jaguilar/self-balancing-cube/self-balancing-cube.ioc

Mcu.UserName=STM32G474MCTx
Mcu.UserName=STM32G474MCTx
PA10.GPIO_Label=M1_PHASEC
PA10.Signal=S_TIM1_CH3
PA11.Signal=USB_DM
PA12.Signal=USB_DP
PA13.GPIO_Label=SWDIO
PA13.Signal=SYS_JTMS-SWDIO
PA14.GPIO_Label=SWCLK
PA14.Signal=SYS_JTCK-SWCLK
PA15.GPIO_Label=I2C1_SCL
PA15.Signal=I2C1_SCL
PA2.GPIO_Label=BRAKE
PA2.Signal=COMP2_OUT
PA3.GPIO_Label=VBATT_SENSE_CMP
PA3.Signal=COMP2_INP
PA4.GPIO_Label=ENC2_CSN
PA4.Signal=S_TIM3_CH2
PA5.GPIO_Label=SPI1_SCLK
PA5.Signal=SPI1_SCK
PA6.GPIO_Label=SPI1_MISO
PA6.Signal=SPI1_MISO
PA7.GPIO_Label=M1_SENSEB
PA7.Signal=ADC2_IN4
PA8.GPIO_Label=M1_PHASEA
PA8.Signal=S_TIM1_CH1
PA9.Signal=USART1_TX
PB0.GPIO_Label=M1_SENSEA
PB0.Signal=ADC1_IN15
PB1.GPIO_Label=M1_NFAULT
PB1.Signal=GPXTI1
PB10.GPIO_Label=M1_NCS
PB10.Signal=GPIO_Output
PB11.GPIO_Label=M2_NCS
PB11.Signal=GPIO_Output
PB12.GPIO_Label=M3_SENSEA
PB12.Signal=ADC1_IN11
PB13.GPIO_Label=M3_NCS
PB13.Signal=GPIO_Output
PB14.GPIO_Label=M2_SENSEA
PB14.Signal=ADC1_IN5
PB15.GPIO_Label=M3_SENSEB
PB15.Signal=ADC2_IN15
PB2.GPIO_Label=M3_PHASEA
PB2.Signal=S_TIM20_CH1
PB3.GPIO_Label=SWO
PB3.Signal=SYS_JTDO-SWO
PB4.GPIO_Label=ENC1_CSN
PB4.Signal=S_TIM3_CH1
PB5.GPIO_Label=SPI1_MOSI
PB5.Signal=SPI1_MOSI
PB6.GPIO_Label=LED_DATA
PB6.Signal=S_TIM4_CH1
PB7.GPIO_Label=I2C1_SDA
PB7.Signal=I2C1_SDA
PB9.GPIO_Label=M2_PHASEC
PB9.Signal=S_TIM8_CH3
PC13.GPIO_Label=EN
PC13.Signal=GPIO_Output
PC14-OSC32_IN.GPIO_Label=CAL
PC14-OSC32_IN.Signal=GPIO_Output
PC2.GPIO_Label=M3_PHASEB
PC2.Signal=S_TIM20_CH2
PC4.GPIO_Label=M2_SENSEB
PC4.Signal=ADC2_IN5
PC5.Signal=USART1_RX
PC6.GPIO_Label=M2_PHASEA
PC6.Signal=S_TIM8_CH1
PC7.GPIO_Label=M2_PHASEB
PC7.Signal=S_TIM8_CH2
PC8.GPIO_Label=M3_PHASEC
PC8.Signal=S_TIM20_CH3
PC9.GPIO_Label=ENC3_CSN
PC9.Signal=S_TIM3_CH4
PD0.GPIO_Label=M1_nFAULT
PD0.Signal=GPIO_Input
PD10.GPIO_Label=M1_NCOAST
PD10.Signal=ADC3_IN7
PD10.Signal=GPIO_Output
PD2.GPIO_Label=IMU_INT
PD2.Signal=GPXTI2
PD8.GPIO_Label=M3_NCOAST
PD8.Signal=GPIO_Output
PD9.GPIO_Label=M2_NCOAST
PD9.Signal=GPIO_Output
PE11.GPIO_Label=M1_PHASEB
PE11.Signal=S_TIM1_CH2
PE12.GPIO_Label=M3_NFAULT
PE12.Signal=GPXTI12
PE13.GPIO_Label=M2_SENSEC
PE13.Signal=ADC3_IN3
PE14.GPIO_Label=VBATT_SENSE
PE14.Signal=ADC4_IN1
PE15.GPIO_Label=IMU_INT
PE15.Signal=GPXTI15
PE7.GPIO_Label=M3_SENSEC
PE7.Signal=ADC3_IN4
PE8.GPIO_Label=M2_NFAULT
PE8.Signal=GPXTI8
PE9.GPIO_Label=M1_SENSEC
PE9.Signal=ADC3_IN2
PF0-OSC_IN.Signal=RCC_OSC_IN
