jaguilar/self-balancing-cube/src/as5048a_spi_sensor.cc

#include "as5048a_spi_sensor.h"

#include <cassert>

#include "cmsis_os2.h"
#include "stm32g4xx_ll_dmamux.h"
#include "stm32g4xx_ll_gpio.h"
#include "stm32g4xx_ll_spi.h"
#include "stm32g4xx_ll_tim.h"
#include "stm32g4xx_ll_usart.h"

namespace stfoc {

namespace internal {
void BusyWaitNs(uint32_t ns) {
  uint32_t start = DWT->CYCCNT;
  uint32_t wait_ticks =
      static_cast<uint32_t>(1.0f * ns * SystemCoreClock / 1e9f);
  while ((uint32_t)(DWT->CYCCNT - start) < wait_ticks) {
  }
}

uint32_t SyncReadSpi(const AsyncTimerSpiConfig& config, uint16_t address) {
  assert(!LL_TIM_IsEnabledCounter(config.tim()) &&
         "Timer must not have been started when SyncReadSpi is called.");
  assert(LL_TIM_GetCounter(config.tim()) == 0 &&
         "Timer counter must be at 0 when SyncReadSpi is called.");
  assert(address <= 0x3FFF && "AS5048A addresses are 14 bits");
  uint16_t read_command = (address & 0x3FFF) | (1 << 14);  // Read bit

  // Calculate Even Parity for 16 bits (including parity bit)
  // We want total number of 1s in the 16-bit word to be even.
  uint16_t temp = read_command;
  temp ^= temp >> 8;
  temp ^= temp >> 4;
  temp ^= temp >> 2;
  temp ^= temp >> 1;
  if (temp & 1) {
    read_command |= (1 << 15);
  }

  auto csn_set_asserted = [&](bool active) {
    LL_TIM_OC_SetMode(
        config.tim(), config.timer_channel_csn,
        active ? LL_TIM_OCMODE_FORCED_ACTIVE : LL_TIM_OCMODE_FORCED_INACTIVE);
    LL_TIM_GenerateEvent_UPDATE(config.tim());
  };

  auto read_write_16 = [&](uint16_t in, uint16_t& out) {
    BusyWaitNs(350);
    csn_set_asserted(true);
    BusyWaitNs(350);
    while (!LL_SPI_IsActiveFlag_TXE(config.spi())) {
    }
    LL_SPI_TransmitData16(config.spi(), in);
    while (!LL_SPI_IsActiveFlag_RXNE(config.spi())) {
    }
    out = LL_SPI_ReceiveData16(config.spi());
    while (LL_SPI_IsActiveFlag_BSY(config.spi())) {
    }
    BusyWaitNs(50);
    csn_set_asserted(false);
  };

  uint16_t response;
  read_write_16(read_command, response);

  uint16_t nop_command = 0x0000;
  read_write_16(nop_command, response);
  return response;
}

uint32_t SpiNRxDmaReq(SPI_TypeDef* spi) {
  if (spi == SPI1) return LL_DMAMUX_REQ_SPI1_RX;
  if (spi == SPI2) return LL_DMAMUX_REQ_SPI2_RX;
  if (spi == SPI3) return LL_DMAMUX_REQ_SPI3_RX;
  if (spi == SPI4) return LL_DMAMUX_REQ_SPI4_RX;
  assert(false && "Unsupported SPI instance");
  return 0;
}

uint32_t TimNChDmaReq(TIM_TypeDef* tim, uint32_t channel) {
  if (channel == LL_TIM_CHANNEL_CH4) {
    if (tim == TIM1) return LL_DMAMUX_REQ_TIM1_CH4;
    if (tim == TIM2) return LL_DMAMUX_REQ_TIM2_CH4;
    if (tim == TIM3) return LL_DMAMUX_REQ_TIM3_CH4;
    if (tim == TIM4) return LL_DMAMUX_REQ_TIM4_CH4;
    if (tim == TIM5) return LL_DMAMUX_REQ_TIM5_CH4;
    if (tim == TIM8) return LL_DMAMUX_REQ_TIM8_CH4;
    if (tim == TIM20) return LL_DMAMUX_REQ_TIM20_CH4;
  } else if (channel == LL_TIM_CHANNEL_CH1) {
    if (tim == TIM15) return LL_DMAMUX_REQ_TIM15_CH1;
  }
  assert(false && "Unsupported timer instance or channel");
  return 0;
}

}  // namespace internal

const uint16_t* AS5048ReadAngleCommandBuf() {
  alignas(uint16_t) static const uint16_t buf[] = {0xFFFF, 0x0000};
  return buf;
}

}  // namespace stfoc
