jaguilar/self-balancing-cube/(commit log)

2026-10-28 Pin bazel version and update lockfile.
2026-11-03 Update cube configuration for V2 board.
2026-11-03 Add hello-world test script for old board.
2026-11-03 Fix certain issues with the devcontainer.
    - Dockerfile redundantly installed certain things that are features.
    - bind-mount /dev so that we can access /dev/ttyACM0.
2026-11-03 Working tests for the icm42670p on our board.
2026-11-03 WIP - v2 board
2026-11-03 Second try, move kicad files to hw/ subdir.
2026-11-04 Drop corrupted controller schematic file.
2026-11-04 Add a new motor driver hardware and motor_driver ioc2 project.
